tumesh007/plate-forge/docs/as-printed.png

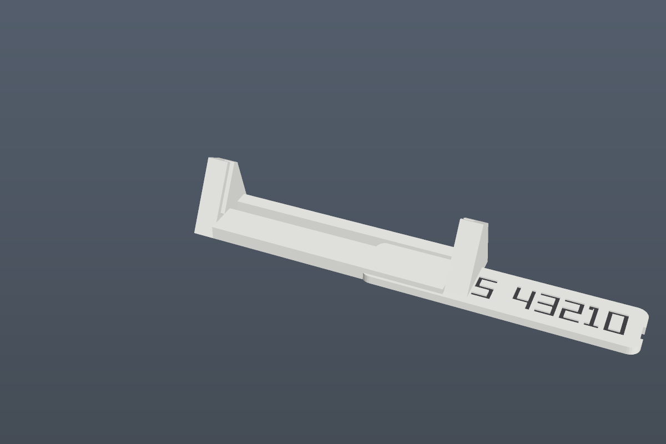
docs/as-printed.png
