tumesh007/plate-forge/test/digits.png

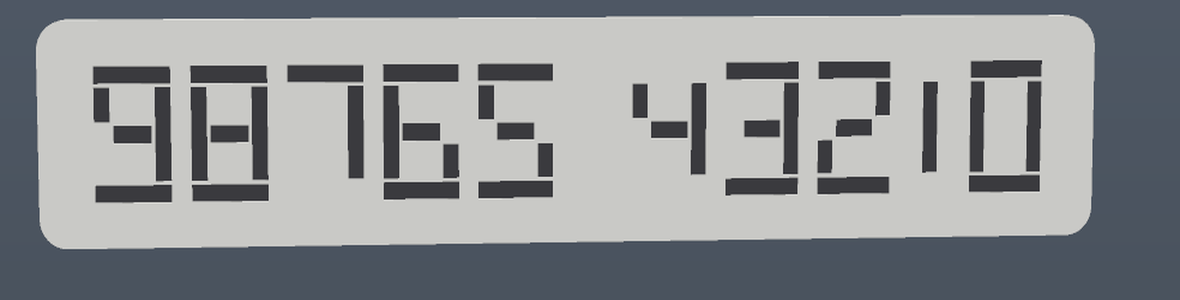
test/digits.png
