tumesh007/plate-forge/test/rack-open.png

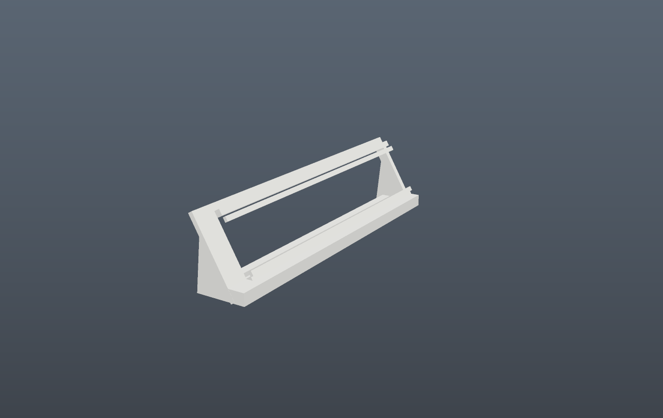
test/rack-open.png
