tumesh007/plate-forge/test/rack-top.png

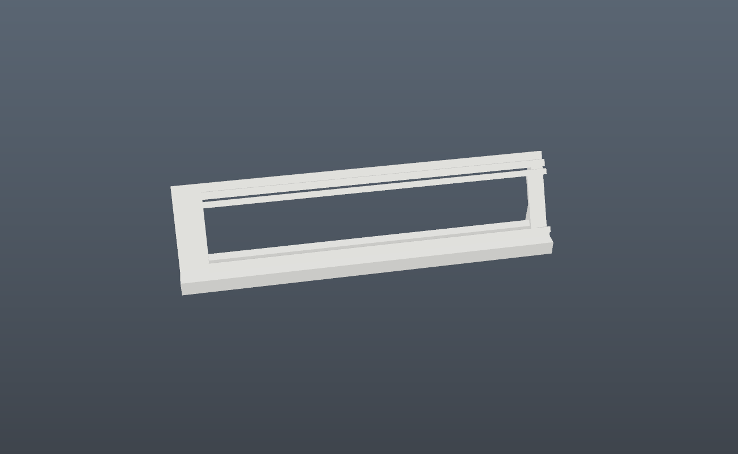
test/rack-top.png
