tumesh007/plate-forge/test/s-digital.png

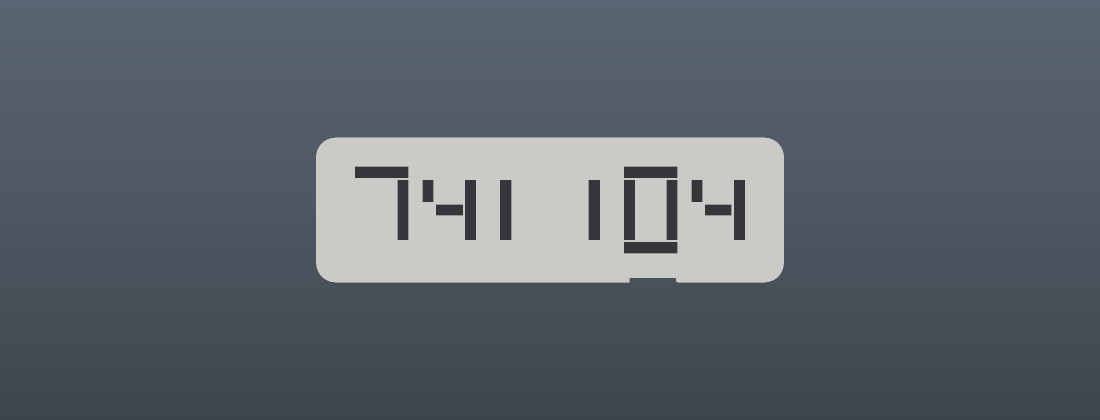
test/s-digital.png
