tumesh007/plate-forge/test/zoom-bare.png

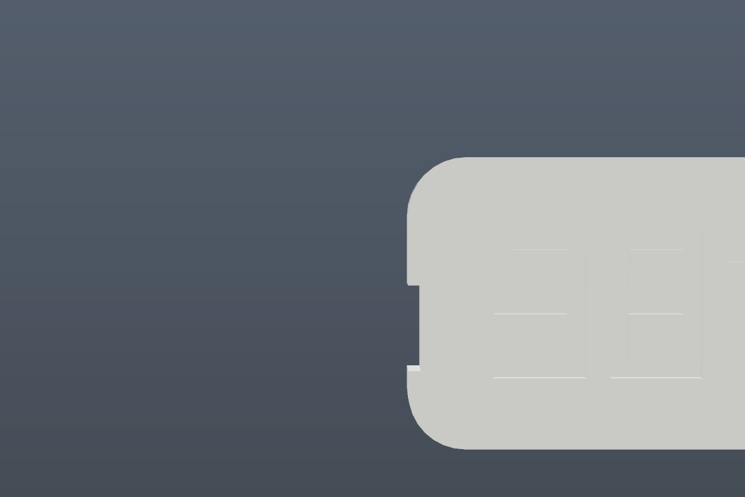
test/zoom-bare.png
