tumesh007/plate-forge/test/zoom-ink.png

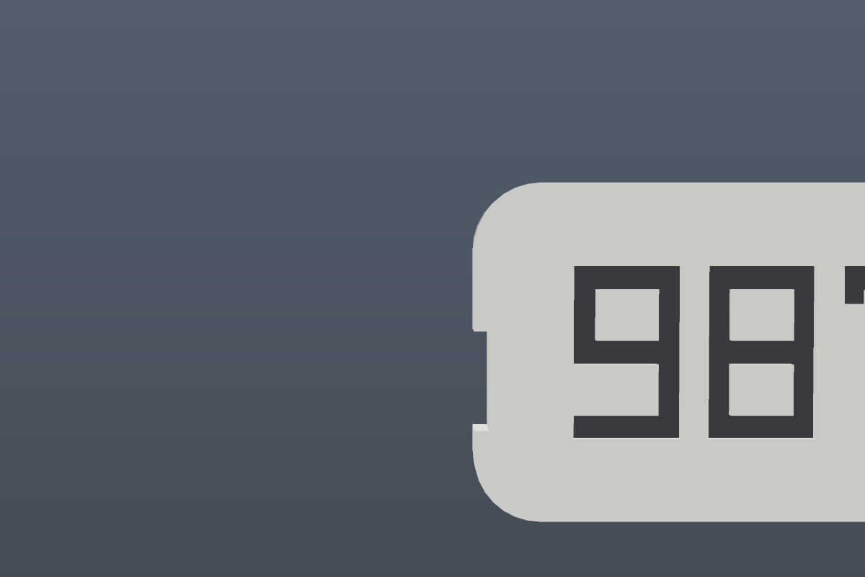
test/zoom-ink.png
