tumesh007/plate-forge/(commit log)

2026-10-25 Plate Forge: parametric parking plate generator
2026-10-25 Pack both parts by wrapping rows so the combined export fits the bed
2026-10-25 Add MakerWorld-ready OpenSCAD model, renders, project document and listing copy
    [plate_forge.scad]
2026-10-25 Rack reloads from the top and prints flat on its back plate
2026-10-25 4 gets a full-width crossbar and open top; add the printable wedge base
2026-10-26 Unify single-piece grooved wedge stand, clean solid typography for 7, 4, 1, and fix preview alignment
    [plate_forge.scad]
2026-10-26 Build 8: Add plate length slider, ground stand monolithic channels on bed, and add dual side key locks
    [plate_forge.scad]
2026-10-26 Build 9: Monolithic grounded uprights with zero floating regions, 100% bed grounding, and OpenSCAD parity
    [plate_forge.scad]
